RedApple2077/Smart-Car/docs/双轮速度控制实现与实验记录.md

# 双轮速度控制实现与实验记录

## 1. 当前状态

截至 2026-11-13，`sc_wheel_service`、`sc_pid`、`sc_speed_controller` 已通过 `sc_app` 接入正式主循环，同时独立 Bench 固件增加了开环 RAW、闭环 SPEED、RAM-only PID 和 100 Hz CAPTURE。LF04 每 10 ms 更新线路；每个新编码器 sequence 进入 Wheel Service，热身后产生约 50 ms 滑窗速度；速度控制只在新的有效反馈上推进，并使用最新 `sc_wheel_target_t`。正式固件和 Bench 均启用约 0.5 s IWDG。用户游标卡尺实测左右轮径为 `48.600 mm`，左右 CPR 均为 `1061`。新 1061 CPR 标尺三轮 Identify 日志 `20261113-121905` 得到 `vL396=489 mm/s`、`vR396=486 mm/s`、离散度均 `1.0%`，固化 `FF_L=810/FF_R=815`；随后 200/500 mm/s 各连续三轮闭环全部通过，`SC_MOTOR_TUNING_VALID=1`。标定依据为 48.600 mm 卡尺、左右十圈中位 1061 CPR、编码器符号匹配和正命令两轮向前；落地有效滚动周长未测但由用户明确豁免，因此 `SC_MOTOR_CALIBRATION_VALID=1`。该豁免不消除几何周长与负载滚动/打滑误差风险。

## 2. 控制器语义

- 控制器形式：并联 PID。
- `kp_milli=1000` 表示 `1 PWM permille / (mm/s)`。
- `ki_milli=1000` 表示 `1 PWM permille / mm`。
- `kd_milli=1000` 表示 `1 PWM permille / (mm/s^2)`。
- `ff_milli=1000` 表示 `1 PWM permille / (mm/s)`。
- PID 使用相邻有效反馈的实际 `dt_ms`，微分作用于测量值；首帧和 reset 后不产生微分项。
- 外部目标为 0 时，该侧目标斜坡值和实际控制输出立即归零，并清除该侧积分与微分历史；另一侧继续按自身目标控制。
- 条件抗饱和同时检查输出限幅，以及输出斜坡后的实际提交值；未完整提交的正/负积分增量被冻结。
- 目标先经过 `2000 mm/s^2` 斜坡，再加上前馈并进入 PID；最终输出经过 `8000 permille/s` 斜坡和 `-564..564` 限幅。

## 3. 轮速窗口

- 编码器每约 10 ms 产生快照。
- Wheel Service 每侧保存最近 6 个有效快照，对应最近 5 个时间差；热身后每来一个约 10 ms 新快照就更新一次约 50 ms 滑窗速度。
- 速度由窗口首末累计总计数差除以实际时间计算，不平均已取整的单帧速度。
- 重复 sequence、30 ms 以上陈旧快照、`interval_ms=0` 重置帧、任一侧 lost_sync 或无效数据均不会形成一个有效的双轮闭环反馈。
- 左右窗口和有效位独立更新；整体有效位要求左右均有效。

## 4. 当前候选默认与证据边界

| 参数 | 当前值 | 状态 |
|---|---:|---|
| 左编码器符号 | `-1` | 正转原始总数为负，方向匹配 |
| 右编码器符号 | `+1` | 正转原始总数为正，方向匹配 |
| 左每转计数 | `1061` | `10602/10617` 中位取整；离散 `0.14%` |
| 右每转计数 | `1061` | `1057.70/1085.10/1060.20/1061.30/1061.40` 中位 `1061.30`；`1085.10` 为离群 |
| 左右轮径 | `48600 um` | 用户游标卡尺实测；十圈直线距离核实未完成 |
| 左右电机符号 | `+1` | 台架正向前进使用；最终线束确认未完成 |
| 当前落地巡航目标 | `400 mm/s` | 差速比例改进后左右振荡已改善；继续上探，PID 增益和 PWM 上限保持不变 |
| 当前循迹严重转向候选 | `400/900`、`100/900`、`300/900` | 中弯/大弯/搜索比例；主机回归与缺陷变异通过，待实车 |
| 左前馈 | `810` | 1061 CPR Identify + 闭环六轮通过 |
| 右前馈 | `815` | 1061 CPR Identify + 闭环六轮通过 |
| 左右 Kp | `100` | 200/500 mm/s 各三轮闭环通过 |
| 左右 Ki | `750` | 200/500 mm/s 各三轮闭环通过 |
| 左右 Kd | `0` | 200/500 mm/s 各三轮闭环通过 |
| 标定有效 | `1` | 卡尺、十圈 CPR、符号和正命令前进已验证；落地滚动周长由用户豁免 |
| 调参有效 | `1` | 仅覆盖 1061 CPR、双轮悬空、200/500 mm/s 各三轮 |

这些值集中在 `Core/Inc/sc_motor_defaults.h`。`TUNING_VALID=1` 只覆盖 1061 CPR、48.60 mm、双轮悬空条件下 200/500 mm/s 各连续三轮；旧 1040 CPR、右轮 1060 候选阶段、旧 `FF_L=798/FF_R=789` 及其闭环数据均已失效。`CALIBRATION_VALID=1` 不表示落地滚动周长已测，只表示在用户豁免该测量后，现有卡尺、十圈计数、方向和正命令前进证据足以进入正式安全门。正式发车仍要求完整按键、中心线路、双轮反馈和全部故障安全门。

## 5. 实验证据与标定边界

### 5.1 48.600 mm 十圈计数阶段结果

| 轮侧 | 样本（左为十圈计数，右为补测 CPR） | 中位数 | 当前取整 CPR | 相对离散度 | 方向原始总数 |
|---|---|---:|---:|---:|---|
| 左 | `10602/10617` | `1060.95` | `1061` | `0.14%` | 正转为负，匹配 `-1` |
| 右 | `1057.70/1085.10/1060.20/1061.30/1061.40` | `1061.30` | `1061` | `1085.10` 为离群，其余集中 | 正转为正，匹配 `+1` |

右轮 `1085.10` 相对其余四个样本明显偏离，已作为离群记录保留；补测后的稳健中位数为 `1061.30`，取整 `1061`。标定有效依据为 48.600 mm 卡尺、左右十圈中位 1061 CPR、编码器符号匹配及正命令两轮向前。落地有效滚动周长没有实测，用户已明确豁免这一前置条件，因此 `CALIBRATION_VALID=1`；几何周长与负载滚动半径、打滑之间的误差仍留作整车风险，不能写成已完成测量。

1061 CPR 标尺下重新执行三轮 Identify，日志 `20261113-121905`：

| 轮次汇总 | 左轮 | 右轮 | 离散度 | FF 建议 | 参数更新 |
|---|---:|---:|---:|---:|---|
| `RAW B 396 1000` 三轮 | `vL396=489 mm/s` | `vR396=486 mm/s` | 左右均 `1.0%` | `ffL=810`、`ffR=815` | 明确单次步长上限 30，`check-update` 通过 |

1061 CPR 标尺下闭环验收结果：

| 目标 | Capture 日志时间戳 | 尾段 MAE 左/右 | 超调 | 调节时间 | 样本/故障 |
|---:|---|---:|---:|---:|---|
| `200 mm/s` | `20261113-122225/122243/122300` | `1.2625..1.825 / 1.1875..3.775 mm/s` | `0.5%` | 左 `0.22..0.24 s`、右 `0.24..0.29 s` | 每轮 201 个 2 s 样本；无饱和/fault |
| `500 mm/s` | `20261113-122316/122330/122345` | `10.5875..11.175 / 11.5875..14.1875 mm/s` | 左 `6.0%`、右 `6.4..7.6%` | 左右均 `0.31 s` | 每轮 201 个 2 s 样本；无饱和/fault |

六轮均通过当前标尺验收。

### 5.2 1040 CPR 历史证据

以下 Identify 与闭环记录均来自更新 CPR 之前，只作历史追溯。其中的 `FF_L=798/FF_R=789` 和 200/500 mm/s 性能结论均已失效：

| 阶段 | 日志时间戳 | 关键结果 |
|---|---|---|
| Identify | `20261113-112810` | `vL396=496 mm/s`、`vR396=502 mm/s`，离散度均 `1.2%`，建议旧 `ffL=798/ffR=789` |
| 200 mm/s | `20261113-113336/113400/113423` | 尾段 MAE 左/右 `0.9375..1.6875 / 2.2875..5.775 mm/s`，超调 `0..3%`，调节 `0.23..0.38 s` |
| 500 mm/s | `20261113-113449/113516/113538` | 尾段 MAE 左/右 `9.95..10.475 / 8.525..11.825 mm/s`，超调 `5.8..6.8%`，调节 `0.31..0.32 s` |

这些记录每轮均为 201 个 2 秒样本，无饱和/fault；但 CPR 更新后不计入当前配置验收。

### 5.3 48.000 mm 标尺历史证据

| 目标 | 尾段 MAE | 峰值超调 | 800 ms 内进入并保持 ±10% | 样本/故障 |
|---:|---:|---:|---:|---|
| `200 mm/s` | `0.825..6.6375 mm/s` | `0..3%` | `0.21..0.23 s` | 每轮 201 个 2 s 样本；无饱和/fault |
| `478 mm/s` | `10.2375..13.6875 mm/s` | `6.0669..8.5774%` | `0.30 s` | 每轮 201 个 2 s 样本；无饱和/fault |

旧参数在 Bench 冷启动镜像中的复测同样属于旧标尺历史：478 mm/s 左/右尾段 MAE 为 `9.3/7.05 mm/s`，超调为 `5.0209/6.0669%`，调节时间为 `0.30/0.30 s`，无饱和或 fault。

落地正常循迹实测表明，中心目标 `500/500 mm/s` 时左轮 PWM 已反复达到 `564‰` 上限，但实测速度长期只有约 `160..200 mm/s`；右轮可接近 `500 mm/s`。旧比例下 300/400 mm/s 均出现过横向振荡；差速比例改进后用户确认左右振荡已改善。当前候选保留微调 `850/1150`，中弯/大弯/搜索为 `400/900`、`100/900`、`300/900`，并将巡航从 300 提高到 400 mm/s：`0x06=400/400`、微调 `340/460`、`0x03=160/360`、`0x01=40/360`、搜索 `120/360`，左右镜像相同。普通已知方向全白持续搜索；该搜索上下文中三路/四路 junction 不计入重捕或十字确认，持续超过 500 ms 仍按原方向搜索，普通非 junction 样本满足三帧/20 ms 才恢复循迹。未知方向、正常十字时限和安全故障仍停车。既有 400 mm/s 日志证实持续全白搜索并暴露恢复态全黑误停，本轮修复尚待新固件实车复测；PID 保持 `100/750/0`，两层速度斜坡和 PWM 上限 564 未改。

- Wheel Service：8/8；缺陷对照 6/6 在目标断言失败。
- PID：6/6；缺陷对照 4/4 在目标断言失败。
- Speed Controller：10/10；缺陷对照 7/7 在目标断言失败。
- Bench：50/50；缺陷对照 28/28 在目标断言失败，覆盖 RAW/SPEED 启动与运行期反馈门、lost_sync/冻结 sequence、运动态与导出门心跳抑制、BUFFER_FULL 非阻塞重试、BEGIN/N、20-count RAW 窗口、PID RAM 写入门、2 秒捕获和自动停。
- App：34/34；缺陷对照 19/19 在目标断言失败，覆盖白线搜索约 1.4 s 后全黑超过 10 s，以及该恢复态下的反馈陈旧/无效、搜索外轮堵转、错误方向、TB6612、线路故障、零目标、方向命令、恢复门和电机符号提交。
- Telemetry：8/8；缺陷对照 5/5 在目标断言失败。
- Track：36/36；缺陷对照 42/42 在目标断言失败，覆盖 400/300/200 mm/s 完整目标、普通已知方向持续搜索、恢复态五种 junction 排除、白线搜索 1500 ms 后全黑从 1520 到 11530 ms、`sample_time_ms` 回绕、恢复后重新进入十字及截止帧退出优先级。
- Safety：3/3；缺陷对照 1/1 在目标断言失败。
- 全量 13 个现有测试套件共 223/223 个基线测试；本轮相关 Track/App 缺陷对照为 61/61。
- Speed Controller、Bench、App、Track、Telemetry、Safety 通过 GCC `-fanalyzer`。
- Debug、Release、Bench 均完成交叉编译。最终 RAM/Flash 分别为 `5240/60428 B`、`5232/32136 B`、`12552/62228 B`。正式 Release 隔离检查未发现 `CH340`、`USART1`、`huart1`、Bench 命令或 `sc_bt_bench` 字符串。

## 6. 正式闭环与故障边界

- 发车要求 `calibration_valid && tuning_valid`、双轮 Wheel Service 有效、当前线路可发车，以及最近约 50 ms 内至少 6 个 10 ms 新鲜中心 `black_mask=0x06` 样本。
- 启用顺序固定为 speed reset -> track reset -> STBY high -> `apply(0,0)` -> ACTIVE。上电已按住、孤立释放和长按后的对应释放均不能发车。
- 任一侧反馈无效会使两路速度输出清零并进入可恢复 FAULT；反馈超过 30 ms、线路无效、未知方向/十字确认丢线、控制失败和调度间隔超过 100 ms 进入可恢复 FAULT。普通已知方向全白只持续搜索，不在 1000 ms 后停车。
- 单轮目标绝对值达到 `50 mm/s` 且已提交 PWM 绝对值至少 `150 permille` 时，启动 300 ms 固定窗口，记录起始物理计数、时间和目标。窗口到期根据目标、实际时间、每转计数和轮径计算理论计数，净进展必须达到至少 20%；单帧正向抖动不重启窗口。目标或输出低于阈值才重置窗口，零目标内侧轮豁免。
- 方向 FATAL 仅在目标与控制器命令同号、且物理计数与命令反向时累计 3 个新 sequence。正目标下的负 PWM 可属于制动或控制回调，不单独触发方向故障。
- 可恢复 FAULT 只有在合法非白线路和反馈新鲜时累计健康时间；`LINE_LOST` 还必须重新满足中心 `0x06` 稳定窗口。连续健康 200 ms 后回到 IDLE/READY；仍必须由下一次完整短按启动。
- 停车顺序为 speed stop -> `apply(0,0)` -> STBY low；任何提交失败立即调用寄存器级紧急停机。

## 7. 遥测与看门狗

- IWDG 使用 LSI 名义 40 kHz、预分频 `/64`、重装 312，名义期限 `0.4992 s`；实际期限受 LSI 容差影响。
- IWDG 初始化先发送启动命令打开 LSI，再解锁并写 PR/RLR；PVU/RVU 等待有固定上限，超时返回错误并由主程序进入紧急停机和错误处理。
- 主循环只在 LF04/编码器采样、App 状态推进、安全提交、MPU/UART/Telemetry 必要 Service 完成后喂狗。受控 FAULT 循环继续喂狗，不会通过看门狗自动重启。
- 正式 HC-05 在 `9600 8N1` 下以 5 Hz 发送单行 CSV：`time_ms,phase,raw,mask,target_l,target_r,measured_l,measured_r,pwm_l,pwm_r,stby,fault,degraded`。
- 每帧一次入队，缓冲失败或帧构建失败整帧丢弃并置 `SC_APP_DEGRADED_TELEMETRY`；不会阻塞控制，也不会把发送入队成功表述为蓝牙远端已连接。
- PWM 字段是经过左右电机符号换算后的实际提交值。OLED 以 2 Hz 显示阶段、线路、目标、实测、PWM、STBY、停止原因和故障位；异步 Service 后还会读取 OLED 状态与重试计数，失败只置显示降级。

## 8. 后续台架与整车验证

1. 保留右轮 `1085.10` 离群记录；若后续获得落地滚动周长或整车直线距离，再评估几何半径、负载滚动和打滑误差。
2. 当前 `TUNING_VALID=1`、`CALIBRATION_VALID=1`，但正式固件仍必须通过完整按键、中心线路、双轮反馈和故障安全门。
3. 保持 `FF_L=810/FF_R=815/Kp=100/Ki=750/Kd=0`、两层速度斜坡和 PWM 上限 564 的 1061 CPR 台架基线；当前把 `400 mm/s` 作为 `850/1150` 微调与 `400/900`、`100/900`、`300/900` 中弯/大弯/搜索候选的落地试验，若不可接受再回退已改善的 `300 mm/s`。
4. `PARAM=UNVERIFIED` 继续作为 Bench 保守标签，表示上述参数只覆盖当前台架证据和用户豁免边界，不代表正式 App 的 VALID 为 0。
5. 在完整赛道验证循迹目标、转向恢复、丢线停车和赛道速度；台架结果不计入整车验收。

## 9. Bench 调参与捕获约束

- `RAW`：`L/R/B`，`abs(pwm)<=564`，时长 100..2000 ms，必须 ARM，且与 SPEED 一样要求 Wheel Service 双轮 valid、样本年龄不超过 30 ms；运行中任一侧 invalid、lost_sync 或超过 30 ms 不依赖新 sequence，立即进入 FEEDBACK 安全停机；B 两侧同号 PWM，到期自动 STOP。
- `SPEED`：`L/R/B`，`abs(target)<=500 mm/s`，时长 100..2000 ms，必须 ARM 且 Wheel Service 双轮有效；B 两侧同目标，单侧实验另一侧目标为 0。
- `PID`：仅 TB6612 standby、未 ARM/active、速度控制器 STOPPED 时允许；Kp/Ki/Kd 范围均为 `-10000..10000`，保留每侧 ff。
- RAW/SPEED 的任一侧出现 `|实际TB命令|>=150` 时启用该侧 300 ms 滚动净进展窗口；SPEED 要求命令与目标同号，目标为 0 的一侧豁免。RAW 每窗口至少需要沿命令方向净增 20 个物理计数，这是标定前尚未经过台架验证的保守安全门槛；SPEED 至少需要达到按目标、实际窗口时间、轮径和 CPR 计算理论计数的 20%。不足时 SAFE STOP、锁存堵转 fault、记录捕获并返回 `ERR STALL`；单帧 `+1` 或每窗仅 `+5` 的累计增长都不重置为合格进展。
- 每次 MOTOR/RAW/SPEED 实验重建捕获，100 Hz，最多 256 条记录。CAPTURE 在停轮后先发送 `OK CAPTURE BEGIN N=<count>`，再发送 CAP 行和 `OK CAPTURE END`；每次 service 最多发送 3 行，TX 满时保留剩余分片。运动 active 与 CAPTURE 导出期间均跳过心跳，Buffer Full 只等待后续 service，不触发安全停机。工具的 Capture、Identify、Step 导出等待窗口统一为 30s；201 行、约 80 B/行在 9600 8N1 下约需 17s。
- 工具核对 BEGIN 声明数量与 CAP 行数精确相等，时间戳严格递增、mode 一致；Identify 的 `RAW/1000 ms` 和 Step 的 `SPEED/命令行 duration` 还必须至少覆盖期望时长的 90%，ExpectedCount 和实际行数都至少达到 `floor(duration_ms/10)+1` 理论样本数的 90%，相邻时间戳间隔不超过 30 ms，且所有 fault 为 0。任何不完整或故障数据先保留原始日志/CSV，再抛错，不生成速度、ff 或 PID 性能结论。
- Identify 三轮中任一轮 `vL396<=0` 或 `vR396<=0` 时不输出建议。三轮左右速度分别计算 `(max-min)/median`，summary 写入 `dispersion_left_ratio`、`dispersion_right_ratio`、`repeatability_ok` 和 `warning`；任一相对离散度超过 10% 即 `repeatability_ok=false`，保留每轮/汇总原始结果但不再给出 cruise/ff。只有全部正值且左右离散度均不超过 10% 才输出建议。
- 第 5.1 节包含当前左右均 `1061 CPR` 的十圈补测、新 Identify 和六轮闭环；5.2/5.3 均只是旧 1040 CPR、旧 FF 798/789 或旧 48.000 mm 标尺的历史证据。基于主机假件的 201 条捕获仍只证明软件时序和导出路径，不代表车辆动力学。
