RedApple2077/Smart-Car/docs/STM32F103C8T6_全部引脚电路图.png

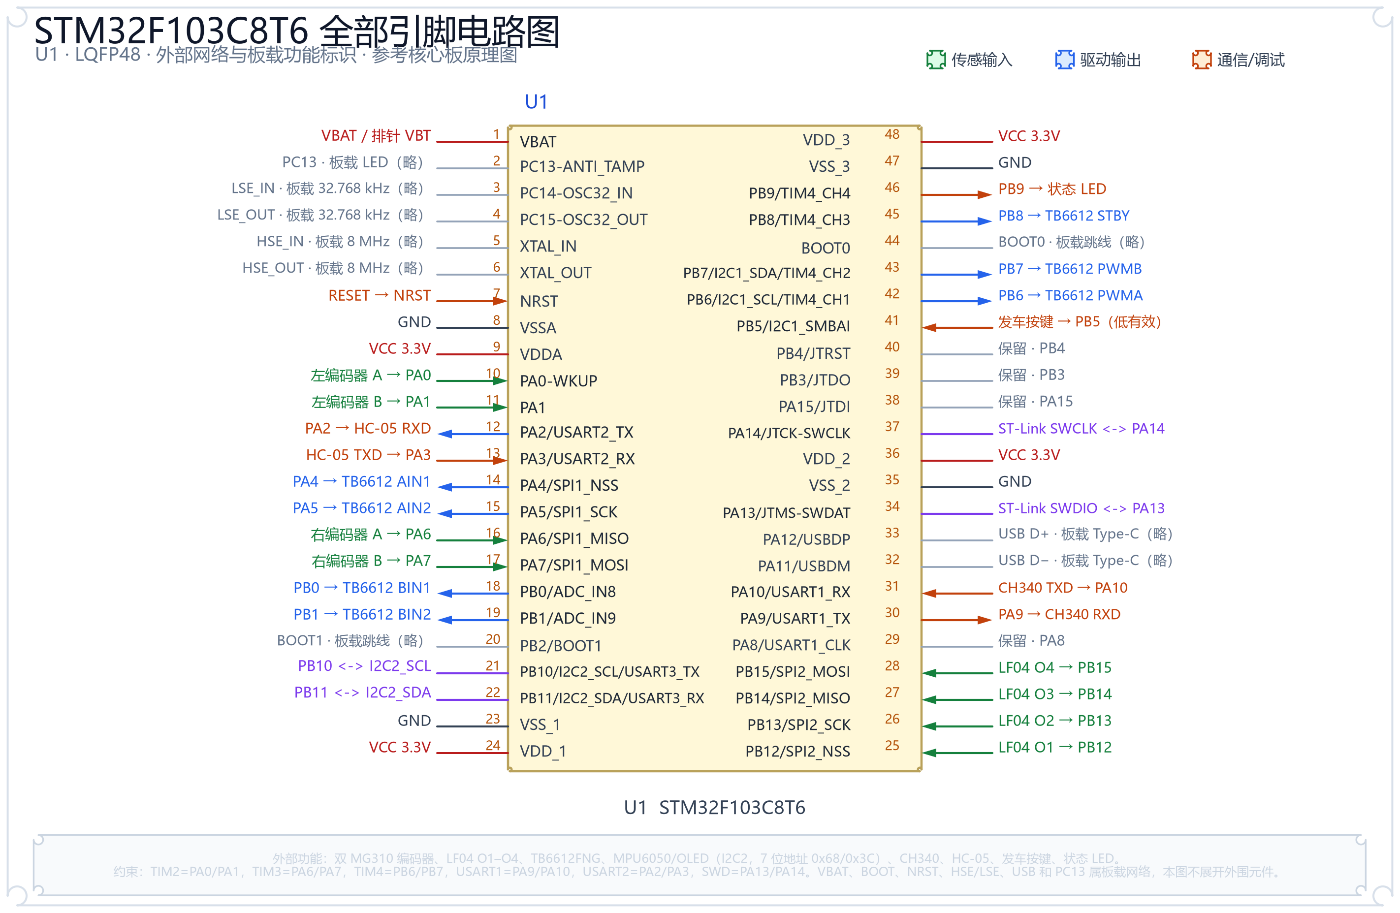
docs/STM32F103C8T6_全部引脚电路图.png
