RedApple2077/Smart-Car/Core/Src/main.c

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
/* Includes ------------------------------------------------------------------*/
#include "main.h"

/* USER CODE BEGIN Includes */
#if !SC_BUILD_HC05_BENCH
#include "sc_app.h"
#include "sc_telemetry.h"
#endif
#include "sc_button.h"
#if SC_BUILD_HC05_BENCH
#include "sc_bt_bench.h"
#endif
#include "sc_encoder.h"
#include "sc_led.h"
#include "sc_lf04.h"
#include "sc_line_service.h"
#include "sc_mpu6050.h"
#include "sc_safety.h"
#include "sc_ssd1306.h"
#if SC_BUILD_HC05_BENCH
#include "sc_tb6612.h"
#endif
#include "sc_uart.h"
/* USER CODE END Includes */

I2C_HandleTypeDef hi2c2;

TIM_HandleTypeDef htim2;
TIM_HandleTypeDef htim3;
TIM_HandleTypeDef htim4;

UART_HandleTypeDef huart2;

/* USER CODE BEGIN PV */
#if !SC_BUILD_HC05_BENCH
static sc_app_t s_app;
static sc_app_config_t s_app_config;
#endif

/* USER CODE END PV */

void SystemClock_Config(void);
static void MX_GPIO_Init(void);
static void MX_I2C2_Init(void);
static void MX_TIM2_Init(void);
static void MX_TIM3_Init(void);
static void MX_TIM4_Init(void);
static void MX_USART2_UART_Init(void);
/**
  * @brief  The application entry point.
  * @retval int
  */
int main(void)
{

  /* MCU Configuration--------------------------------------------------------*/

  /* Reset of all peripherals, Initializes the Flash interface and the Systick. */
  HAL_Init();

  /* Configure the system clock */
  SystemClock_Config();

  /* Initialize all configured peripherals */
  MX_GPIO_Init();
  MX_I2C2_Init();
  MX_TIM2_Init();
  MX_TIM3_Init();
  MX_TIM4_Init();
  MX_USART2_UART_Init();
  /* USER CODE BEGIN 2 */
  /* CubeMX 生成的 MX_USART2_UART_Init() 是平台启动前提，失败由生成函数进入
     Error_Handler；正式固件不挂接收，只有 Bench 固件启用 HC-05 入站。 */

#if SC_BUILD_HC05_BENCH
  /* Bench 保持原有台架初始化与命令行为。 */
  if ((sc_led_init() != SC_LED_OK) ||
      (sc_button_init() != SC_BUTTON_OK) ||
      (sc_tb6612_init() != SC_TB6612_OK) ||
      (sc_encoder_init() != SC_ENCODER_OK) ||
      (sc_lf04_init() != SC_LF04_OK))
  {
    Error_Handler();
  }
  (void)sc_uart_init(9600u, 1u);
  sc_bt_bench_init(HAL_GetTick());
  if (sc_mpu6050_init() == SC_MPU6050_OK)
  {
    (void)sc_mpu6050_start_calibration(128u);
  }
  (void)sc_ssd1306_init();
#else
  sc_app_get_default_config(&s_app_config);
  if (sc_app_init(&s_app, &s_app_config, HAL_GetTick()) != SC_APP_OK)
  {
    sc_safety_emergency_stop();
  }
  if (sc_uart_init(9600u, 0u) != SC_UART_OK)
  {
    (void)sc_app_report_degraded(&s_app, SC_APP_DEGRADED_TELEMETRY);
  }
  if (sc_mpu6050_init() == SC_MPU6050_OK)
  {
    if (sc_mpu6050_start_calibration(128u) != SC_MPU6050_OK)
    {
      (void)sc_app_report_degraded(&s_app, SC_APP_DEGRADED_IMU);
    }
  }
  else
  {
    (void)sc_app_report_degraded(&s_app, SC_APP_DEGRADED_IMU);
  }
  if (sc_ssd1306_init() != SC_SSD1306_OK)
  {
    (void)sc_app_report_degraded(&s_app, SC_APP_DEGRADED_DISPLAY);
  }
  sc_telemetry_init(HAL_GetTick());
#endif
  if (sc_safety_iwdg_init() != SC_SAFETY_OK)
  {
    Error_Handler();
  }
  /* USER CODE END 2 */

  /* Infinite loop */
  /* USER CODE BEGIN WHILE */
  while (1)
  {
    /* USER CODE END WHILE */

    /* USER CODE BEGIN 3 */
    uint32_t now_ms = HAL_GetTick();
#if SC_BUILD_HC05_BENCH
    sc_line_sample_t line_sample = {
      .raw_levels = 0u,
      .sample_time_ms = now_ms,
      .sequence = 0u,
      .valid = 0u
    };

    if (sc_lf04_sample(now_ms, &line_sample) != SC_LF04_OK)
    {
      line_sample.sample_time_ms = now_ms;
      line_sample.valid = 0u;
    }
    (void)sc_line_service_update(&line_sample);
    (void)sc_encoder_service(now_ms);
    sc_bt_bench_service(now_ms);
    sc_mpu6050_service(now_ms);
    sc_ssd1306_service(now_ms);
    sc_uart_service();
#else
    sc_app_snapshot_t snapshot;
    uint32_t degraded_bits = 0u;

    (void)sc_app_service(&s_app, now_ms);
    if (sc_app_snapshot(&s_app, &snapshot) == SC_APP_OK)
    {
      (void)sc_telemetry_service(&snapshot, now_ms, &degraded_bits);
      if (degraded_bits != 0u)
      {
        (void)sc_app_report_degraded(&s_app, degraded_bits);
      }
    }
    else
    {
      sc_safety_emergency_stop();
    }
    sc_mpu6050_service(now_ms);
    sc_uart_service();
#endif
    sc_safety_iwdg_feed();
  }
  /* USER CODE END 3 */
}

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
