RedApple2077/Smart-Car/Smart-Car.ioc

Mcu.UserName=STM32F103C8Tx
PA0-WKUP.Signal=S_TIM2_CH1_ETR
PA1.Signal=S_TIM2_CH2
PA13.Signal=SYS_JTMS-SWDIO
PA14.Signal=SYS_JTCK-SWCLK
PA2.Signal=USART2_TX
PA3.Signal=USART2_RX
PA4.GPIO_Label=AIN1
PA4.Signal=GPIO_Output
PA5.GPIO_Label=AIN2
PA5.Signal=GPIO_Output
PA6.Signal=S_TIM3_CH1
PA7.Signal=S_TIM3_CH2
PB0.GPIO_Label=BIN1
PB0.Signal=GPIO_Output
PB1.GPIO_Label=BIN2
PB1.Signal=GPIO_Output
PB10.Signal=I2C2_SCL
PB11.Signal=I2C2_SDA
PB12.GPIO_Label=LF04_O1
PB12.Signal=GPIO_Input
PB13.GPIO_Label=LF04_O2
PB13.Signal=GPIO_Input
PB14.GPIO_Label=LF04_O3
PB14.Signal=GPIO_Input
PB15.GPIO_Label=LF04_O4
PB15.Signal=GPIO_Input
PB5.GPIO_Label=START_BTN
PB5.Signal=GPIO_Input
PB6.Signal=S_TIM4_CH1
PB7.Signal=S_TIM4_CH2
PB8.GPIO_Label=TB6612_STBY
PB8.Signal=GPIO_Output
PB9.GPIO_Label=STATUS_LED
PB9.Signal=GPIO_Output
PC14-OSC32_IN.Signal=RCC_OSC32_IN
PC15-OSC32_OUT.Signal=RCC_OSC32_OUT
PD0-OSC_IN.Signal=RCC_OSC_IN
PD1-OSC_OUT.Signal=RCC_OSC_OUT
