RedApple2077/Smart-Car/Core/Inc/sc_font5x7.h

/**
  ******************************************************************************
  * @file    sc_font5x7.h
  * @brief   SSD1306 5x7 ASCII 字模（0x20..0x7E，每字符 5 列）。
  *          字模来自 Adafruit GFX Library 的 glcdfont.c：
  *          Copyright (c) 2012 Adafruit Industries. BSD license.
  *          https://github.com/adafruit/Adafruit-GFX-Library
  *          bit0 为字符顶部，bit6 为字符底部；本文件只由 sc_ssd1306.c 包含。
  ******************************************************************************
  */

#ifndef __SC_FONT5X7_H
#define __SC_FONT5X7_H

#include <stdint.h>

static const uint8_t sc_font5x7[95][5] = {
  { 0x00, 0x00, 0x00, 0x00, 0x00 }, /* 0x20 */
  { 0x00, 0x00, 0x5F, 0x00, 0x00 }, /* 0x21 */
  { 0x00, 0x07, 0x00, 0x07, 0x00 }, /* 0x22 */
  { 0x14, 0x7F, 0x14, 0x7F, 0x14 }, /* 0x23 */
  { 0x24, 0x2A, 0x7F, 0x2A, 0x12 }, /* 0x24 */
  { 0x23, 0x13, 0x08, 0x64, 0x62 }, /* 0x25 */
  { 0x36, 0x49, 0x56, 0x20, 0x50 }, /* 0x26 */
  { 0x00, 0x08, 0x07, 0x03, 0x00 }, /* 0x27 */
  { 0x00, 0x1C, 0x22, 0x41, 0x00 }, /* 0x28 */
  { 0x00, 0x41, 0x22, 0x1C, 0x00 }, /* 0x29 */
  { 0x2A, 0x1C, 0x7F, 0x1C, 0x2A }, /* 0x2A */
  { 0x08, 0x08, 0x3E, 0x08, 0x08 }, /* 0x2B */
  { 0x00, 0x80, 0x70, 0x30, 0x00 }, /* 0x2C */
  { 0x08, 0x08, 0x08, 0x08, 0x08 }, /* 0x2D */
  { 0x00, 0x00, 0x60, 0x60, 0x00 }, /* 0x2E */
  { 0x20, 0x10, 0x08, 0x04, 0x02 }, /* 0x2F */
  { 0x3E, 0x51, 0x49, 0x45, 0x3E }, /* 0x30 */
  { 0x00, 0x42, 0x7F, 0x40, 0x00 }, /* 0x31 */
  { 0x72, 0x49, 0x49, 0x49, 0x46 }, /* 0x32 */
  { 0x21, 0x41, 0x49, 0x4D, 0x33 }, /* 0x33 */
  { 0x18, 0x14, 0x12, 0x7F, 0x10 }, /* 0x34 */
  { 0x27, 0x45, 0x45, 0x45, 0x39 }, /* 0x35 */
  { 0x3C, 0x4A, 0x49, 0x49, 0x31 }, /* 0x36 */
  { 0x41, 0x21, 0x11, 0x09, 0x07 }, /* 0x37 */
  { 0x36, 0x49, 0x49, 0x49, 0x36 }, /* 0x38 */
  { 0x46, 0x49, 0x49, 0x29, 0x1E }, /* 0x39 */
  { 0x00, 0x00, 0x14, 0x00, 0x00 }, /* 0x3A */
  { 0x00, 0x40, 0x34, 0x00, 0x00 }, /* 0x3B */
  { 0x00, 0x08, 0x14, 0x22, 0x41 }, /* 0x3C */
  { 0x14, 0x14, 0x14, 0x14, 0x14 }, /* 0x3D */
  { 0x00, 0x41, 0x22, 0x14, 0x08 }, /* 0x3E */
  { 0x02, 0x01, 0x59, 0x09, 0x06 }, /* 0x3F */
  { 0x3E, 0x41, 0x5D, 0x59, 0x4E }, /* 0x40 */
  { 0x7C, 0x12, 0x11, 0x12, 0x7C }, /* 0x41 */
  { 0x7F, 0x49, 0x49, 0x49, 0x36 }, /* 0x42 */
  { 0x3E, 0x41, 0x41, 0x41, 0x22 }, /* 0x43 */
  { 0x7F, 0x41, 0x41, 0x41, 0x3E }, /* 0x44 */
  { 0x7F, 0x49, 0x49, 0x49, 0x41 }, /* 0x45 */
  { 0x7F, 0x09, 0x09, 0x09, 0x01 }, /* 0x46 */
  { 0x3E, 0x41, 0x41, 0x51, 0x73 }, /* 0x47 */
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
};

#endif /* __SC_FONT5X7_H */
