RedApple2077/Smart-Car/(commit log)

2026-11-08 feat: initialize STM32 smart car project
    加入 STM32F103 循迹小车的 CubeMX/CMake 工程、驱动与构建配置。
    保留 GitHub 仓库已有的 README，并以本地工程作为后续开发基线。
2026-11-09 feat: add camera control test module
2026-11-09 feat: Add I2C2, TIM2, TIM3, TIM4, USART1, and USART2 peripherals
    - Implemented I2C2 initialization and configuration in main.c and HAL MSP files.
    - Added TIM2, TIM3, and TIM4 initialization functions for encoder and PWM modes.
    - Configured USART1 and USART2 for asynchronous communication with respective baud rates.
    - Updated GPIO initialization for new peripherals and configured interrupt handlers for USART1 and USART2.
    - Modified system clock configuration to use HSE and PLL for higher frequency operation.
    - Updated project configuration in .ioc file to include new peripherals and settings.
2026-11-09 feat: 添加 STM32F103C8T6 接线图
2026-11-09 feat: 添加按键与状态 LED 驱动模块
    - 新增 sc_button/sc_led 驱动：PB5 上拉输入、按下为低；PB9 高电平点亮
    - 按键 20 ms 消抖并输出按下/释放/3 s 长按事件，不使用 GPIO 中断
    - main.c 初始化并轮询按键，台架验证按住点亮、释放熄灭
    - CMake 加入新驱动源文件
2026-11-09 chore: 更新 VS Code 工程配置与忽略规则
2026-11-09 docs: 同步当前工程事实
    更新 README 的项目入口信息与当前状态，并同步规划文档 1.3 的时钟、外设、GPIO 和实现边界。
    依据 Smart-Car.ioc、Core/Src/main.c 与 CMake 配置核对，避免将已完成初始化描述为已完成比赛功能。已验证 Debug 配置与构建通过。
2026-11-10 feat: 添加 SSD1306 OLED 显示模块
    - 新增 sc_types.h：文档 7.2 运行快照公共类型
    - 新增 sc_ssd1306 驱动：I2C2 0x3C、128x64 页刷新、超时降级
    - 新增 5x7 ASCII 字模与 sc_ssd1306_show()
    - main.c 加入 OLED 台架演示快照和按键状态行
    - CMake 加入 sc_ssd1306.c
2026-11-10 chore: 移除台架验证代码，仅保留模块驱动
    - main.c 删除按键/LED 与 OLED 台架演示逻辑
    - 保留 sc_button/sc_led/sc_ssd1306 驱动及初始化
    - 保留 sc_ssd1306_show() 等模块 API
2026-11-10 更新按钮、LED 和 SSD1306 模块。状态返回类型为 sc_button_status_t、sc_led_status_t 和 sc_ssd1306_status_t，移除对 sc_status.h 的依赖
2026-11-11 Add unit tests for SC UART functionality with a mock HAL
    - Created CMakeLists.txt for sc_uart_host_tests to manage test builds.
    - Implemented fake HAL functions in fake_hal.c to simulate UART behavior.
    - Defined main.h to provide necessary type definitions and function prototypes for the fake HAL.
    - Developed run_mutant_tests.ps1 script to automate the testing of mutant code changes.
    - Added test_sc_uart.c containing various test cases for SC UART, including initialization, error handling, and data transmission.
    [fake_hal.c, main.c, main.h, sc_uart.c, sc_uart.h, test_sc_uart.c]
2026-11-11 feat(i2c): add MPU6050 and async OLED drivers
    新增共享 I2C2 协调层，统一管理阻塞初始化和异步收发事务，避免 MPU6050 与 OLED 争用 HAL 回调或并发启动传输。
    新增 MPU6050 六轴采样、固定配置校验、128 样本 gyro-Z 校零和失效隔离；角速度保持未扣零偏的驱动测量值。重构 SSD1306 刷新为 32 B 分块异步状态机，加入页代次保护和失败退避，并启用 CubeMX I2C2 EV/ER 中断。
    新增独立主机测试和 13 个隔离缺陷变体，覆盖 I2C 配置、采样换算、校零、OLED 分块、故障隔离及总线独占。
    验证：I2C2 CTest 15/15，sc_uart CTest 10/10；GCC -fanalyzer 通过；隔离缺陷 1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
2026-11-11 feat(motor): add TB6612 and encoder drivers
    新增 TB6612 双路 PWM 安全控制和时间驱动式霍尔编码器，接入 CubeMX 已生成的 TIM2、TIM3、TIM4 配置。TB6612 在初始化、停机和错误路径保持 STBY 低，零命令使用高阻停转；编码器支持 16 位回绕、失同步冻结和软件重置。正式固件仅初始化驱动，不主动输出电机功率。\n\n验证：sc_motor 主机测试 23/23，通过 17/17 隔离缺陷变体、-fanalyzer 和 Debug/Release 交叉编译。
2026-11-11 feat(bench): add isolated HC-05 control firmware
    新增永久保留的 HC-05 Bench 构建，仅在该固件中启用 PING、STATUS、ARM、MOTOR、STOP 和 RESET 命令；正式 Debug/Release 保持静默且不编译命令解析。命令层限制单轮 150 千分比、最长 2 秒，自动停机，并对越界、重复运动、非法字符、UART 溢出和驱动错误执行安全停止。\n\n验证：Bench 主机测试 24/24，通过 9/9 隔离缺陷变体、Bench fanalyzer 和 Debug/Release/Bench 交叉编译；正式镜像符号及协议字符串审计通过。ST-Link 烧录校验成功，HC-05 COM13 完成 Probe 与四个 2 秒方向脉冲，单轮隔离和自动停机正常；右电机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
    [fake_bench.c, fake_bench.h, main.c, sc_bt_bench.c, sc_bt_bench.h, test_sc_bt_bench.c]
2026-11-11 feat(line): add LF04 driver and HC-05 query
    新增 LF04 四路采样、黑线掩码与线路语义 Service，并在主循环中保持失败隔离和非阻塞安全调度。
    Bench 固件支持 LINE/LF 查询，调试脚本增加只读 Line 动作，不触发 ARM/MOTOR。补充全部 16 种位型、配置校验、驱动到 Bench 集成和安全停机测试及缺陷变体。
    验证：sc_line 13/13（Debug/Release/fanalyzer），Bench 31/31（含 fanalyzer），缺陷 11/11 与 13/13；Debug/Release/Bench 交叉构建通过。LF04 实物未接线，硬件黑白、极性和安装顺序未验证。
2026-11-11 docs: refresh project status
    更新 README 的模块状态、Debug/Release/Bench 构建、蓝牙台架命令、测试结果、安全约束和后续工作。
    同步规划文档的当前工程事实与验收口径，区分已完成软件验证、部分硬件台架验证和仍需实物测试的项目。
    检查 Markdown 链接、代码围栏、CRLF 和过期状态描述；本提交仅修改文档，未重新运行固件构建。
2026-11-12 feat: 实现四路红外循迹控制
    新增差速循迹、丢线找回与十字直行策略，并补充回归测试和完整调试日志。
2026-11-12 refactor(safety): isolate HC-05 UART and harden stops
    移除 CH340/USART1，将非阻塞串口收敛到 HC-05/USART2，并区分正式遥测与 Bench 双工模式。修正上电按键抑制和单侧零输出时的 TB6612 快路径，增加寄存器级紧急停机并覆盖所有 CPU 异常入口。同步更新主机测试、缺陷对照、交叉构建和硬件/API 文档。验证：sc_uart 13/13 且 mutant 3/3；sc_motor 24/24 且 mutant 18/18；sc_button 3/3；sc_safety 1/1；Debug、Release、Bench 交叉构建通过。
    [Smart-Car.ioc, fake_bench.c, fake_hal.c, fake_registers.c, fake_support.c, main.c, main.h, sc_bt_bench.c]
2026-11-12 feat(control): add wheel feedback and dual PID
    新增单侧编码器符号与轮径换算的滑动窗口 Wheel Service，按最近 50 ms 总线计数和实际时间生成 10 ms 速度反馈。新增并联 PID 与左右独立速度控制器，包含前馈、实际 dt、测量微分、条件抗饱和、目标/输出斜坡和 564 千分比限幅。标定与调参有效标志保持 0，参数集中到编译期默认入口，未宣称实车收敛。验证：Wheel 8/8 且 mutant 6/6；PID 6/6 且 mutant 4/4；Speed Controller 9/9 且 mutant 6/6；全量 CTest 130/130；GCC -fanalyzer 和 Debug/Release/Bench 构建通过。
2026-11-12 feat(app): close loop through safety state machine
    将循迹策略改为 mm/s 左右目标，并新增 BOOT/IDLE/READY/ACTIVE/STOPPING/FAULT 应用状态机。正式链由 Wheel Service 与双轮 PID 驱动，应用层唯一提交 TB6612，加入中心线发车门、长按释放抑制、滚动净进展堵转、方向故障、反馈/调度超时、分类恢复、IWDG 与非阻塞 HC-05 遥测/OLED/LED。移除直接 PWM 循迹入口，保留 Bench 隔离路径；标定和调参有效位仍为 0。验证：App 24/24 且 mutant 10/10；Track 13/13 且 mutant 7/7；Telemetry 8/8 且 mutant 5/5；Safety 3/3 且 mutant 1/1；全量 CTest 170/170；Debug/Release/Bench 构建及 ELF 隔离审计通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
2026-11-12 feat(bench): add HC-05 PID tuning workflow
    为独立 Bench 固件加入 RAW、SPEED、PID 和 CAPTURE 命令，接入 Wheel Service 与双轮速度控制器，提供 100 Hz、256 条滑动记录和非阻塞导出。新增 HC-05 SPP 调参脚本，支持三轮开环识别、RAM-only PID 回读、闭环阶跃和 CSV 输出，并校验蓝牙容器与三轮一致性。正式固件保持严格隔离。验证：Bench 39/39 且 mutant 18/18；Speed Controller 10/10 且 mutant 7/7；全量 CTest 179/179；三套 ARM 构建、GCC -fanalyzer、ELF 隔离与 PowerShell AST 通过。实物 Probe 因当前 HC-05 SPP 链路无法打开而未发送运动命令。
2026-11-12 docs: normalize speed log file ending
    移除实验记录末尾多余空行，使 git diff --check 保持通过。
2026-11-12 fix(bench): harden capture and motion tuning
    Bench 运动中抑制心跳，Capture 改为带总行数的 BEGIN/CAP/END 非阻塞协议，并在 TX 背压下保留发送进度。RAW/SPEED 增加按轮净进展堵转截止，上位机校验样本数量、100 Hz 密度、时间递增、覆盖率和故障位；设备身份必须与 HC-05 PnP 容器一致。验证：Bench 46/46 且 mutant 26/26；PowerShell AST、adapter 5/5、capture 7/7；三套 ARM 构建通过。
    [sc_bt_bench.c, test_sc_bt_bench.c]
2026-11-12 fix(bench): gate RAW on fresh wheel feedback
    RAW 与 SPEED 现在共用双轮 feedback 有效性、30 ms 新鲜度和 lost_sync/冻结监控；运行中反馈失效立即保存捕获、锁存故障并撤销 STBY。将 RAW 标定前最小净进展提高到每 300 ms 20 counts，覆盖每窗仅 5 counts 的累计缓慢异常。验证：Bench 50/50 且 mutant 28/28；Debug/Release/Bench 构建通过。
    [sc_bt_bench.c, test_sc_bt_bench.c]
2026-11-13 feat(control): persist validated dual-wheel speed settings
    将台架闭环验收后的巡航速度、前馈和双轮 PID 固化到默认配置，并将调参有效位置为 1。保留标定有效位为 0，因为尚未完成十圈计数、轮径和方向人工核实，正式固件继续拒绝发车。
    验证：13 套主机测试 190/190；App、Speed Controller、Bench 缺陷对照分别为 10/10、7/7、28/28；Bench 固件冷启动回读参数一致，200/478 mm/s 复测通过；Debug/Release/Bench 交叉编译通过。
2026-11-13 feat(control): calibrate 48.6 mm wheels for 500 mm/s cruise
    按游标卡尺实测将左右轮径更新为 48600 um，并把巡航目标改为 500 mm/s。新标尺三轮 Identify 得到左右前馈 798/789，保留 100/750/0 的 PID 并在 200/500 mm/s 各连续三轮闭环验收通过后恢复调参有效位。
    保持标定有效位为 0，因为十圈计数、落地有效滚动周长和最终方向尚未人工核实，正式固件继续拒绝发车。文档保留旧 48.000 mm 历史数据，并记录 500 mm/s 直行通过不能替代转弯与整车验收。
    验证：13 套主机测试 190/190；App/Speed/Wheel/Bench 缺陷对照 10/10、7/7、6/6、28/28；Debug/Release/Bench 构建通过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
2026-11-13 fix(control): finalize 1061 CPR calibration and 500 mm/s tune
    将左右每转计数更新为 1061，保留 48.600 mm 轮径和 500 mm/s 巡航；按新标尺 Identify 将左右前馈更新为 810/815，并保持 Kp/Ki/Kd 为 100/750/0。1061 CPR 下 200/500 mm/s 各连续三轮通过后，调参和标定有效位均置 1。
    落地有效滚动周长未测，依据用户明确豁免完成标定放行；文档保留几何周长、负载变形、打滑及大弯外侧 712 mm/s 限幅风险。方向矩阵改为使用映射后的 Lspeed/Rspeed 判据，并已通过正命令两轮向前验证。
    验证：全量 13 套主机测试 190/190；Debug/Release/Bench 构建通过；Release 不含 Bench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
    [sc_motor_defaults.h, test_sc_app.c, test_sc_bt_bench.c, test_sc_speed_controller.c]
2026-11-13 feat(track): add junction-safe recovery control
    调整 LF04 循迹差速目标，降低急弯比例并将巡航候选设为 400 mm/s。新增经过连续样本确认的十字状态机，并在已知方向找线期间排除 junction，避免长时间全白后重遇全黑误触发十字超时。
    保持双轮 PI、前馈、速度斜坡和 564‰ PWM 上限不变；继续保留编码器、堵转、方向及 TB6612 安全门。补齐 Track/App 状态、端点和目标断言缺陷对照，并记录振荡诊断与实车验证边界。
    验证：13 套 CTest 223/223；Track/App 缺陷对照 42/42、19/19；Debug/Release/Bench 构建及 Track/App GCC -fanalyzer 通过。Release 已烧录并通过 Fl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
